tpwade/1D_BFieldTrace/(commit log)

2025-04-04 This is pretty close to the version I have had working using the arduino nano board doing just the Encoder and magnetometer steps. Will have to update it for Uno R4 Minima operation with pickup loop 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
2025-04-23 Added in the Encoder library (PaulStoffregen/Encoder commit c7627dd) as local to the project folder (src folder) and updated code and Readme
2025-04-23 added in matlab directory with some sample processing scripts
